yniu42-a11y/ECE455_SP26/SP26_CabinetClub_Dispenser_AustinClyne/SP26_DispenserRail_CadFile_AustinClyne.SLDPRT

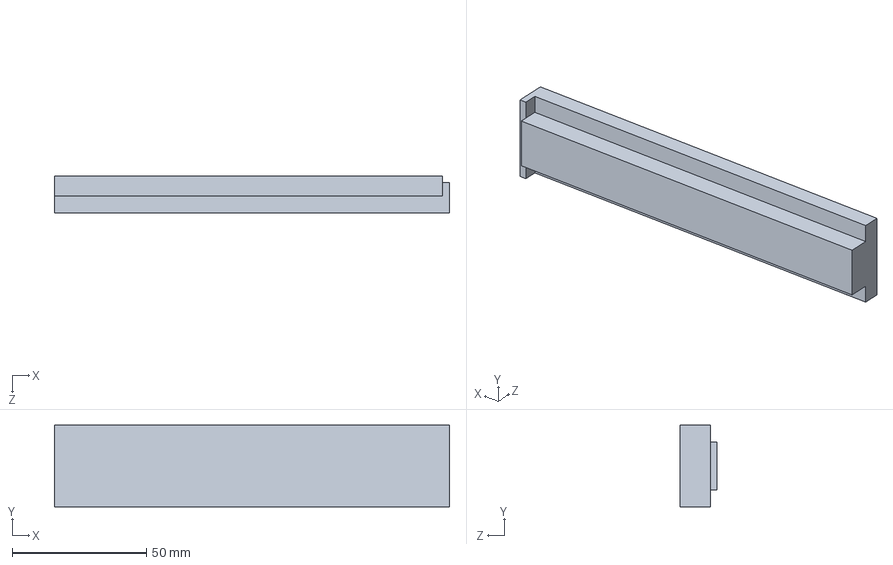
[picture p1: CAD file, 2026-05-05]
SP26_CabinetClub_Dispenser_AustinClyne/SP26_DispenserRail_CadFile_AustinClyne.SLDPRT
147.3 x 30.5 x 14.0 mm
