yniu42-a11y/ECE455_SP26/SP26_CabinetClub_LockboxCadfiles_AustinClyne/SP26_Lockbox_Wall_AustinClyne.SLDPRT

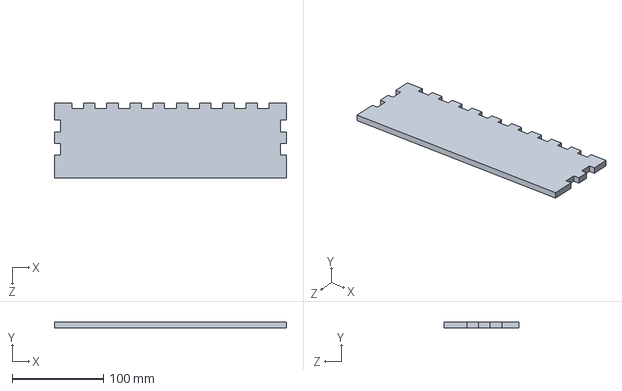
[picture p2: CAD file, 2026-05-05]
SP26_CabinetClub_LockboxCadfiles_AustinClyne/SP26_Lockbox_Wall_AustinClyne.SLDPRT
254.0 x 6.35 x 82.5 mm
