yniu42-a11y/ECE455_SP26/SP26_CabinetClub_Dispenser_AustinClyne/SP26_Spring Mount_CadFile_AustinClyne.SLDPRT

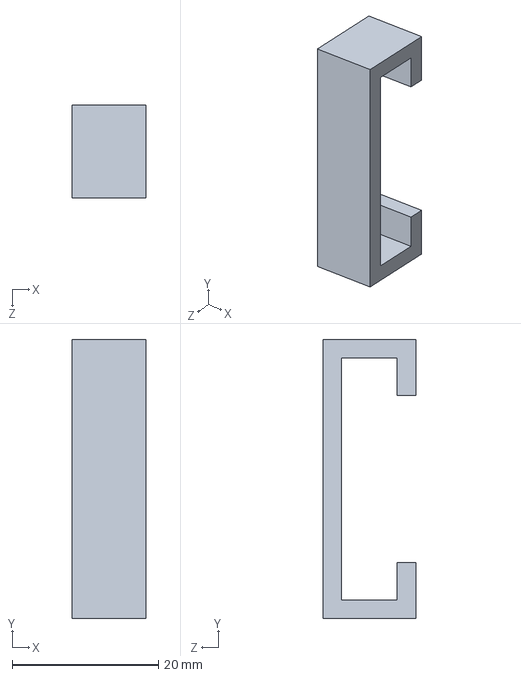
[picture p3: CAD file, 2026-05-05]
SP26_CabinetClub_Dispenser_AustinClyne/SP26_Spring Mount_CadFile_AustinClyne.SLDPRT
10.2 x 38.1 x 12.7 mm
