yniu42-a11y/ECE455_SP26/SP26_CabinetClub_LockboxCadfiles_AustinClyne/SP26_Back Face_AustinClyne.SLDPRT

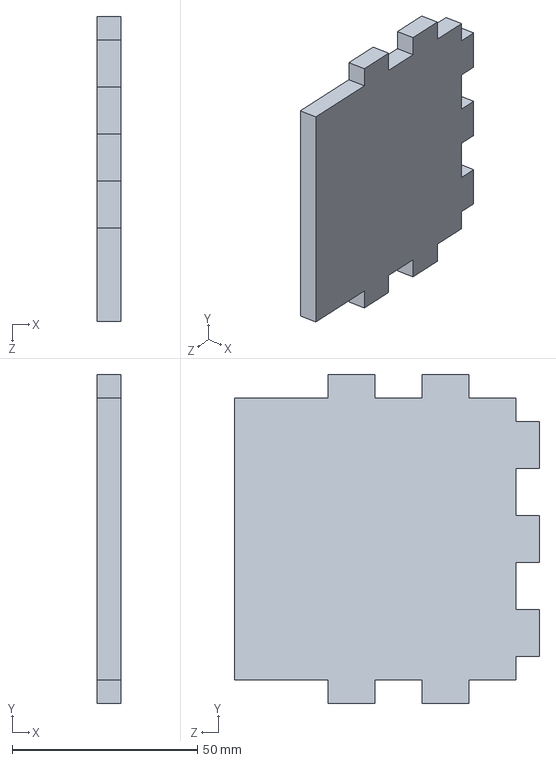
[picture p4: CAD file, 2026-05-05]
SP26_CabinetClub_LockboxCadfiles_AustinClyne/SP26_Back Face_AustinClyne.SLDPRT
6.35 x 88.9 x 82.5 mm
