yniu42-a11y/ECE455_SP26/SP26_CabinetClub_Dispenser_AustinClyne/SP26_Dispenser lid_CadFile_AustinClyne.SLDPRT

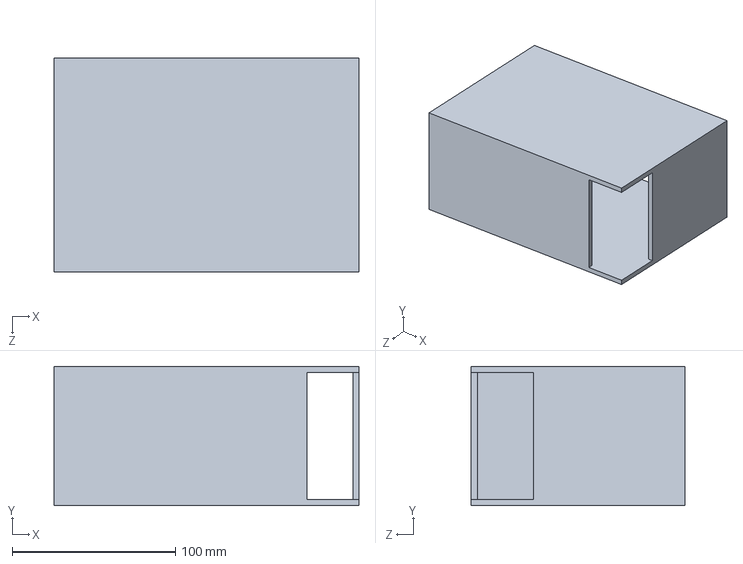
[picture p5: CAD file, 2026-05-05]
SP26_CabinetClub_Dispenser_AustinClyne/SP26_Dispenser lid_CadFile_AustinClyne.SLDPRT
186.7 x 85.1 x 130.8 mm
