yniu42-a11y/ECE455_SP26/SP26_CabinetClub_Dispenser_AustinClyne/SP26_Sensor_Platform_CadFile_AustinClyne.SLDPRT

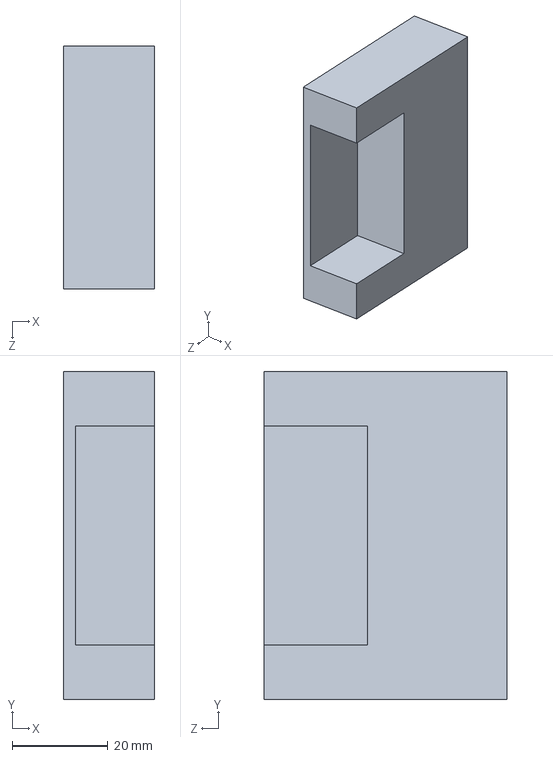
[picture p6: CAD file, 2026-05-05]
SP26_CabinetClub_Dispenser_AustinClyne/SP26_Sensor_Platform_CadFile_AustinClyne.SLDPRT
19.1 x 68.6 x 50.8 mm
