yniu42-a11y/ECE455_SP26/SP26_CabinetClub_LockboxCadfiles_AustinClyne/SP_26_LockboxBottom_AustinClyne.SLDPRT

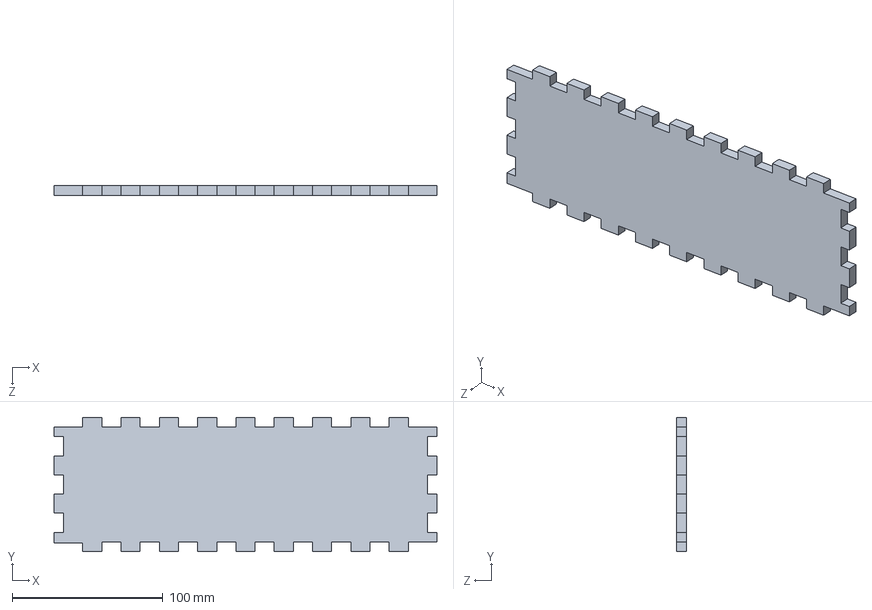
[picture p7: CAD file, 2026-05-05]
SP26_CabinetClub_LockboxCadfiles_AustinClyne/SP_26_LockboxBottom_AustinClyne.SLDPRT
254.0 x 88.9 x 6.35 mm
