yniu42-a11y/ECE455_SP26/SP26_CabinetClub_Dispenser_AustinClyne/SP26_Pusher plate_Cad_File_AustinClyne.SLDPRT

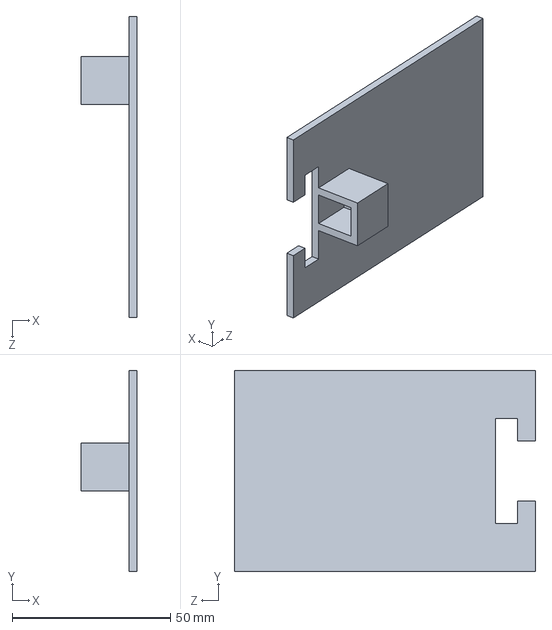
[picture p8: CAD file, 2026-05-05]
SP26_CabinetClub_Dispenser_AustinClyne/SP26_Pusher plate_Cad_File_AustinClyne.SLDPRT
17.8 x 63.5 x 95.2 mm
