yniu42-a11y/ECE455_SP26/SP26_CabinetClub_LockboxCadfiles_AustinClyne/SP26_False base of dispenser_AustinClyne.SLDPRT

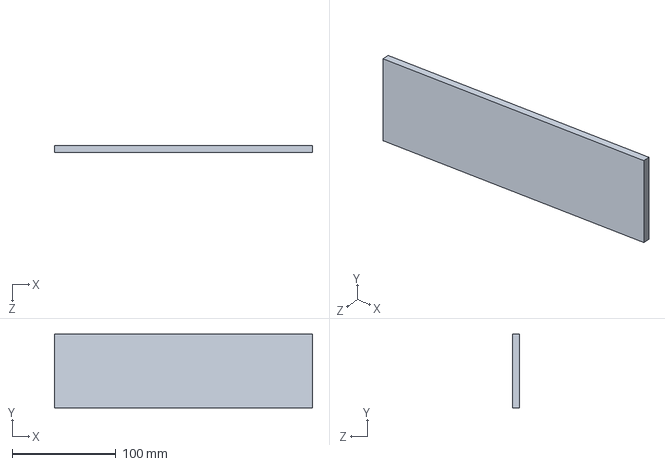
[picture p9: CAD file, 2026-05-05]
SP26_CabinetClub_LockboxCadfiles_AustinClyne/SP26_False base of dispenser_AustinClyne.SLDPRT
248.9 x 71.1 x 6.35 mm
