yniu42-a11y/ECE455_SP26/SP26_CabinetClub_Dispenser_AustinClyne/SP26_Ultrasonic sensor_CadFile_AustinClyne.SLDPRT

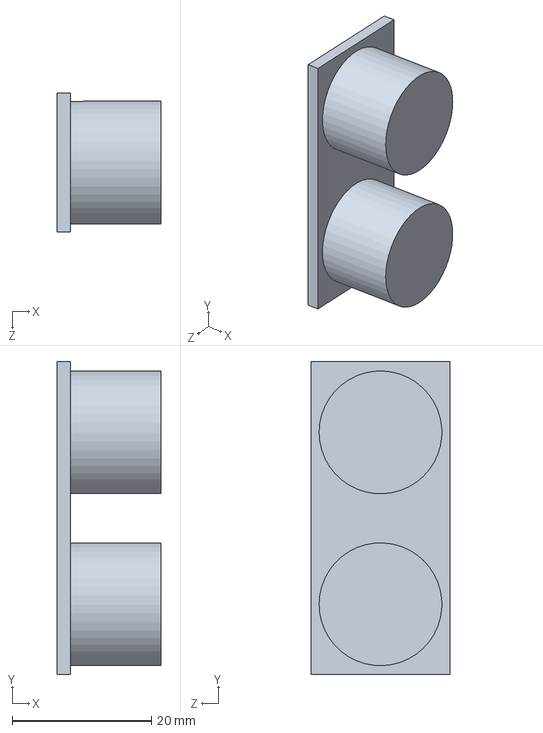
[picture p10: CAD file, 2026-05-05]
SP26_CabinetClub_Dispenser_AustinClyne/SP26_Ultrasonic sensor_CadFile_AustinClyne.SLDPRT
15.0 x 45.0 x 20.0 mm
