yniu42-a11y/ECE455_SP26/SP26_CabinetClub_Dispenser_AustinClyne/SP26_Dispenser base_CadFile_AustinClyne.SLDPRT

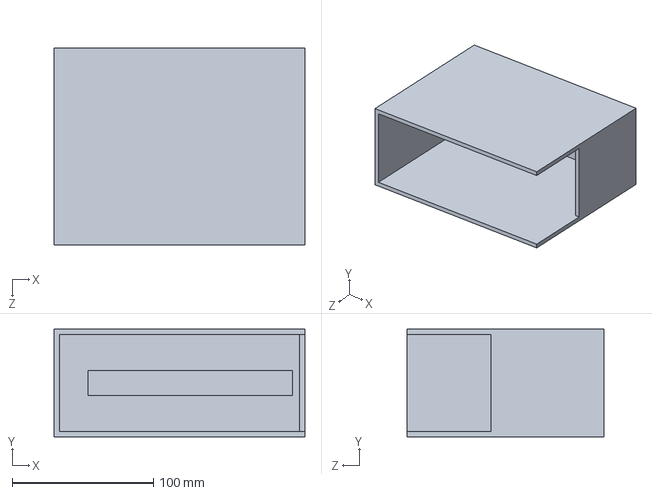
[picture p11: CAD file, 2026-05-05]
SP26_CabinetClub_Dispenser_AustinClyne/SP26_Dispenser base_CadFile_AustinClyne.SLDPRT
177.8 x 76.2 x 139.7 mm
