yniu42-a11y/ECE455_SP26/(list of files, cad)

Other CAD files:
SP26_CabinetClub_LockboxCadfiles_AustinClyne/SP26_Front Face_AustinClyne.SLDPRT
