yniu42-a11y/ECE455_SP26/SP26_CabinetClub_LockboxControl_JohnPinto.kicad_pcb

## KiCad design SP26_CabinetClub_LockboxControl_JohnPinto.kicad_pcb (2026-05-05)

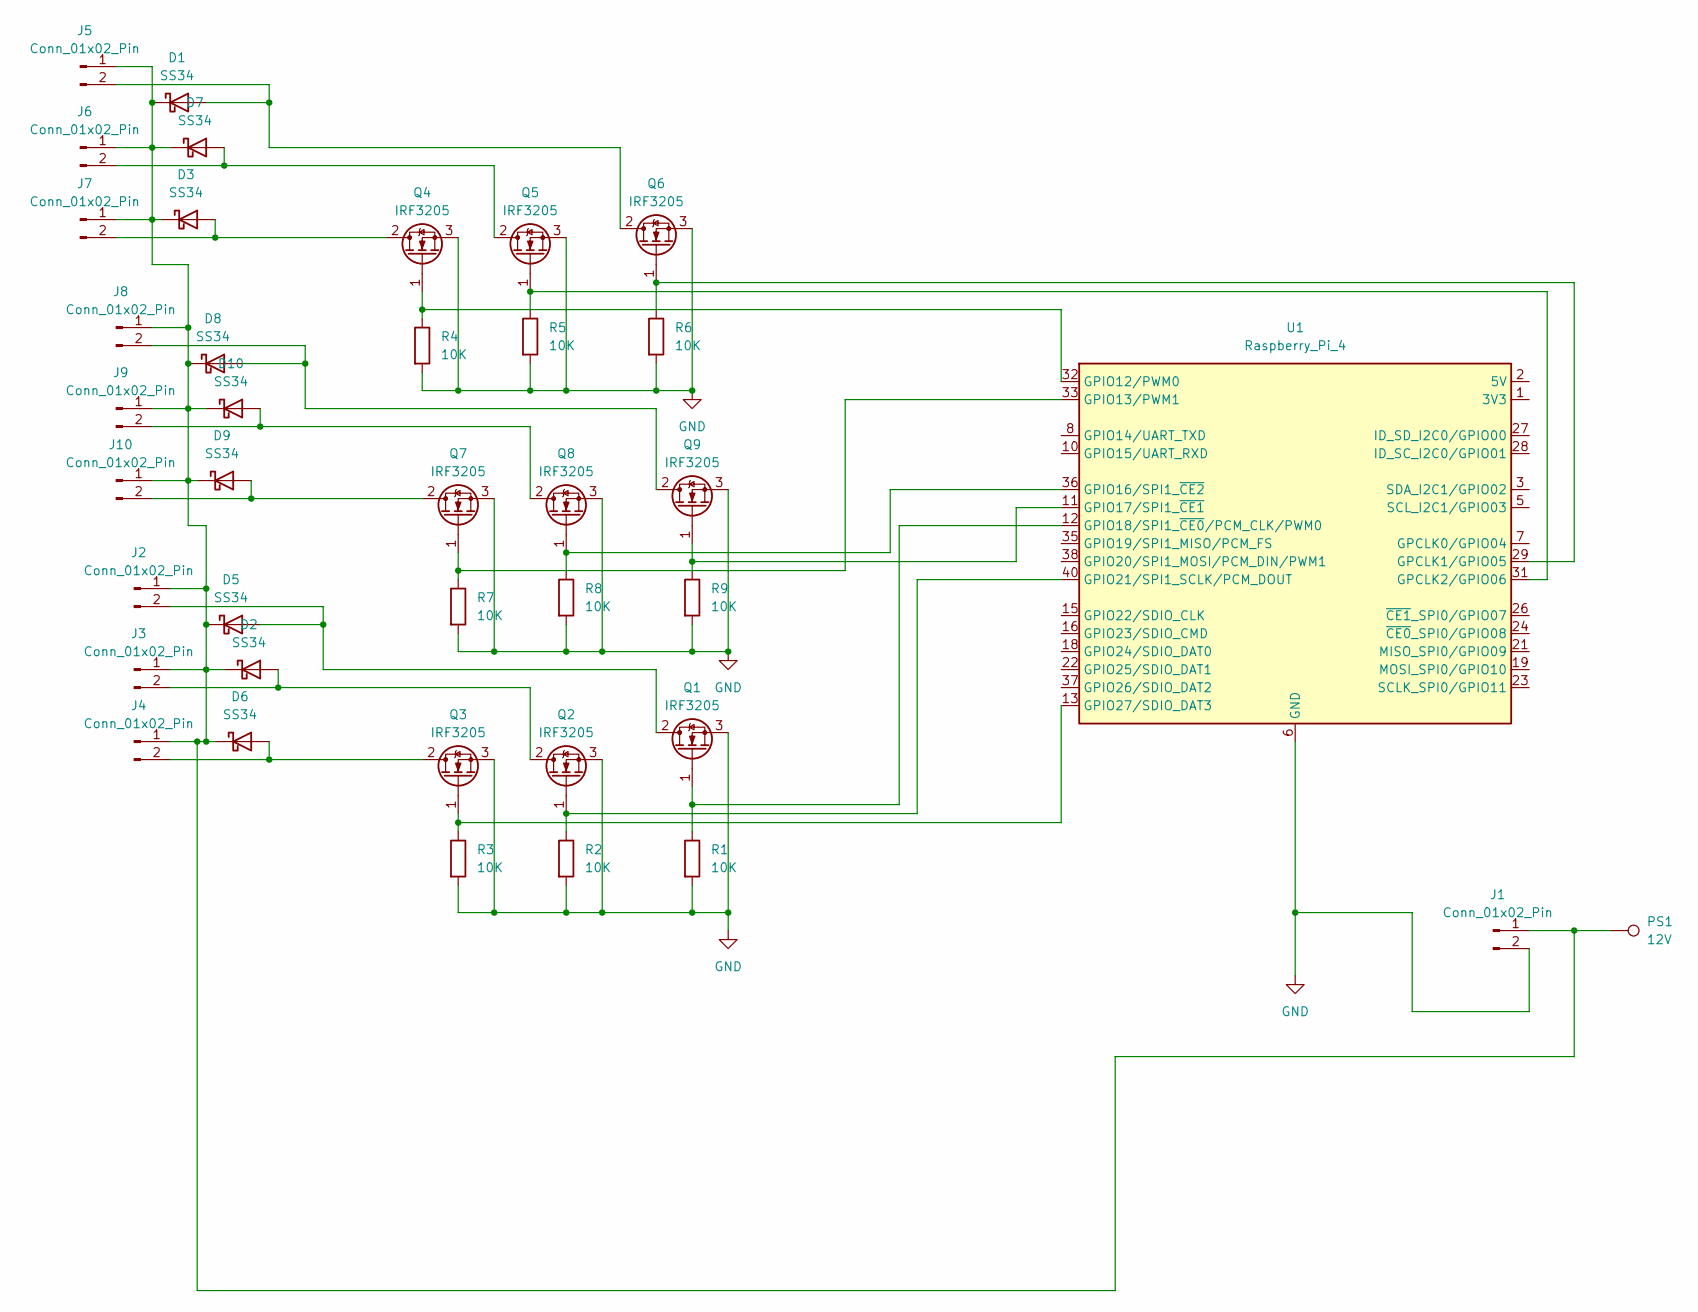
[picture p13: schematic SP26_CabinetClub_LockboxControl_JohnPinto.kicad_sch]

Parts:
D1, D2, D3, D5, D6, D7, D8, D9, D10: SS34; D_SMA
J1, J2, J3, J4, J5, J6, J7, J8, J9, J10: Conn_01x02_Pin; JST_EH_B2B-EH-A_1x02_P2.50mm_Vertical
PS1: 12V; TestPoint_Keystone_5000-5004_Miniature
Q1, Q2, Q3, Q4, Q5, Q6, Q7, Q8, Q9: IRF3205; TO-220-3_Vertical
R1, R2, R3, R4, R5, R6, R7, R8, R9: 10K; R_1206_3216Metric_Pad1.30x1.75mm_HandSolder
U1: Raspberry_Pi_4; PinHeader_2x20_P2.54mm_Vertical_SMD

Connections:
GND: J1.2, Q1.3 (S), Q2.3 (S), Q3.3 (S), Q4.3 (S), Q5.3 (S), Q6.3 (S), Q7.3 (S), Q8.3 (S), Q9.3 (S), R1.2, R2.2, R3.2, R4.2, R5.2, R6.2, R7.2, R8.2, R9.2, U1.6 (GND), U1.9 (GND), U1.14 (GND), U1.20 (GND), U1.25 (GND), U1.30 (GND), U1.34 (GND), U1.39 (GND)
unnamed: D1.2 (A), J5.2, Q6.2 (D)
unnamed: D1.1 (K), D2.1 (K), D3.1 (K), D5.1 (K), D6.1 (K), D7.1 (K), D8.1 (K), D9.1 (K), D10.1 (K), J1.1, J2.1, J3.1, J4.1, J5.1, J6.1, J7.1, J8.1, J9.1, J10.1, PS1.1
unnamed: D2.2 (A), J3.2, Q2.2 (D)
unnamed: D3.2 (A), J7.2, Q4.2 (D)
unnamed: D5.2 (A), J2.2, Q1.2 (D)
unnamed: D6.2 (A), J4.2, Q3.2 (D)
unnamed: D7.2 (A), J6.2, Q5.2 (D)
unnamed: D8.2 (A), J8.2, Q9.2 (D)
unnamed: D9.2 (A), J10.2, Q7.2 (D)
unnamed: D10.2 (A), J9.2, Q8.2 (D)
unnamed: Q1.1 (G), R1.1, U1.12 (GPIO18/SPI1_~CE0/PCM_CLK/PWM0)
unnamed: Q2.1 (G), R2.1, U1.40 (GPIO21/SPI1_SCLK/PCM_DOUT)
unnamed: Q3.1 (G), R3.1, U1.13 (GPIO27/SDIO_DAT3)
unnamed: Q4.1 (G), R4.1, U1.32 (GPIO12/PWM0)
unnamed: Q5.1 (G), R5.1, U1.31 (GPCLK2/GPIO06)
unnamed: Q6.1 (G), R6.1, U1.29 (GPCLK1/GPIO05)
unnamed: Q7.1 (G), R7.1, U1.33 (GPIO13/PWM1)
unnamed: Q8.1 (G), R8.1, U1.36 (GPIO16/SPI1_~CE2)
unnamed: Q9.1 (G), R9.1, U1.11 (GPIO17/SPI1_~CE1)
unnamed: U1.1 (3V3), U1.17 (3V3)
unnamed: U1.2 (5V), U1.4 (5V)

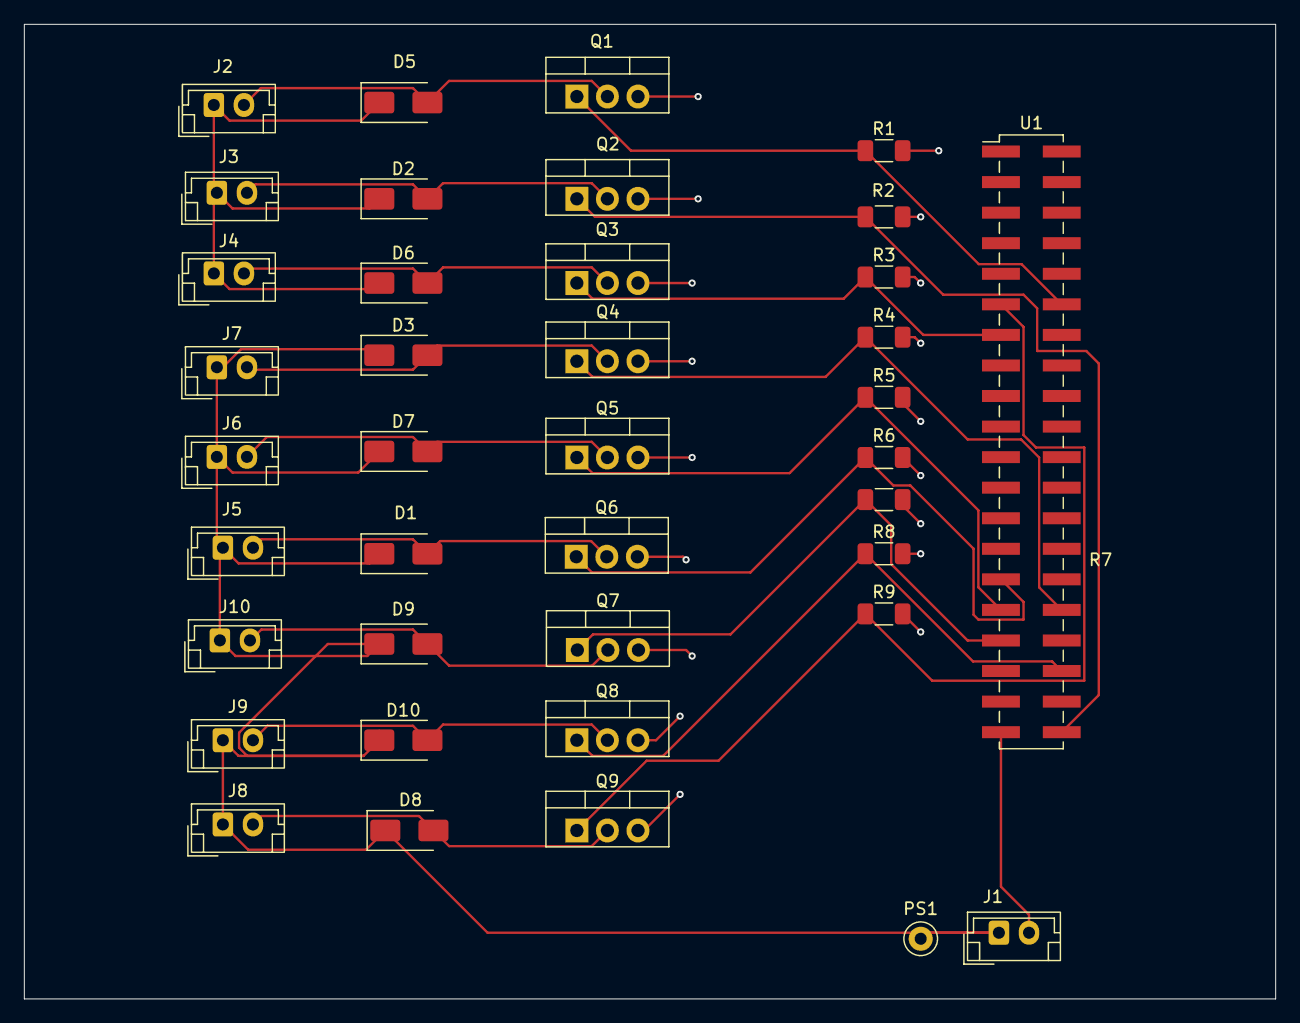
[picture p14: board SP26_CabinetClub_LockboxControl_JohnPinto.kicad_pcb from above]

Board: 2 copper layers, 104.0 x 81.0 mm, 39 parts (0 on the bottom side), 22 nets.
