yniu42-a11y/ECE455_SP26/(commit log)

2026-05-05 Rename Dispenser Rail.SLDPRT to SP26_DispenserRail_CadFile_AustinClyne.SLDPRT
    [SP26_DispenserRail_CadFile_AustinClyne.SLDPRT]
2026-05-05 Rename Sensor Platform.SLDPRT to SP26_Sensor_Platform_CadFile_AustinClyne.SLDPRT
    [SP26_Sensor_Platform_CadFile_AustinClyne.SLDPRT]
2026-05-05 Rename Spring Mount.SLDPRT to SP26_Spring Mount_CadFile_AustinClyne.SLDPRT
    [SP26_Spring Mount_CadFile_AustinClyne.SLDPRT]
2026-05-05 Rename Ultrasonic sensor.SLDPRT to SP26_Ultrasonic sensor_CadFile_AustinClyne.SLDPRT
    [SP26_Ultrasonic sensor_CadFile_AustinClyne.SLDPRT]
2026-05-05 Rename Pusher plate.SLDPRT to SP26_Pusher plate_Cad_File_AustinClyne.SLDPRT
    [SP26_Pusher plate_Cad_File_AustinClyne.SLDPRT]
2026-05-05 Rename Dispenser lid.SLDPRT to SP26_Dispenser lid_CadFile_AustinClyne.SLDPRT
    [SP26_Dispenser lid_CadFile_AustinClyne.SLDPRT]
2026-05-05 Rename Dispenser base.SLDPRT to SP26_Dispenser base_CadFile_AustinClyne.SLDPRT
    [SP26_Dispenser base_CadFile_AustinClyne.SLDPRT]
2026-05-05 Rename Back Face.SLDPRT to SP26_Back Face_AustinClyne.SLDPRT
    [SP26_Back Face_AustinClyne.SLDPRT]
2026-05-05 Rename False base of dispenser.SLDPRT to SP26_False base of dispenser_AustinClyne.SLDPRT
    [SP26_False base of dispenser_AustinClyne.SLDPRT]
2026-05-05 Rename Front Face.SLDPRT to SP26_Front Face_AustinClyne.SLDPRT
    [SP26_Front Face_AustinClyne.SLDPRT]
2026-05-06 Rename Capstone CAD final submission.zip to SP26_Carousel CAD final submission_IanCherkauer.zip
